ThunderFly-aerospace/TFPROBE01/doc_report/docs/TFPROBE01A-report.txt

# PCB

Board size: 14.0x10.0 mm (0.55x0.39 inches)

- This is the size of the rectangle that contains the board
- Thickness: 1.6 mm (63 mils)
- Material: FR4
- Finish: None
- Layers: 2
- Copper thickness: 35 µm

Solder mask: TOP / BOTTOM

- Color: Green

Silk screen: TOP / BOTTOM

- Color: White

Stackup:

| Name | Type | Color | Thickness | Material | Epsilon_r | Loss tangent |
|---|---|---|---|---|---|---|
| F.SilkS | Top Silk Screen | | | | | |
| F.Paste | Top Solder Paste | | | | | |
| F.Mask | Top Solder Mask | Green | 10 | | | |
| F.Cu | copper | | 35 | | | |
| dielectric 1 | core | | 1510 | FR4 | 4.5 | 0.02 |
| B.Cu | copper | | 35 | | | |
| B.Mask | Bottom Solder Mask | Green | 10 | | | |
| B.Paste | Bottom Solder Paste  | | | | | |
| B.SilkS | Bottom Silk Screen | | | | | |

# Important sizes

Clearance: 0.2 mm (8 mils)

Track width: 0.2 mm (8 mils)

- By design rules: 0.2 mm (8 mils)

Drill: 0.4 mm (16 mils)

- Vias: 0.4 mm (16 mils) [Design: 0.3 mm (12 mils)]
- Pads: 0.89 mm (35 mils)

Via: 0.8/0.4 mm (31/16 mils)

- By design rules: 0.4/0.3 mm (16/12 mils)
- Micro via: no [0.2/0.1 mm (8/4 mils)]
- Burried/blind via: no

Outer Annular Ring: 0.4 mm (16 mils)

- By design rules: 0.4 mm (16 mils)

Eurocircuits class: 4C

# General stats

Components count: (SMD/THT)

- Top: 0/3 (THT)
- Bottom: 4/1 (SMD + THT)

Defined tracks:

- 0.2 mm (8 mils)
- 0.3 mm (12 mils)
- 0.4 mm (16 mils)
- 0.5 mm (20 mils)

Used tracks:

- 0.2 mm (8 mils) (5) defined: yes
- 0.3 mm (12 mils) (3) defined: yes
- 0.5 mm (20 mils) (30) defined: yes

Defined vias:

- 0.8/0.4 mm (31/16 mils)

Used vias:

- 0.8/0.4 mm (31/16 mils) (Count: 10, Aspect: 2.0 A) defined: yes

Holes (excluding vias):

- 0.89 mm (35 mils) (3)
- 3.0 mm (118 mils) (2)
