ThunderFly-aerospace/TFPROBE01/doc/gen/img/pcb/TFPROBE01A-bottom.png

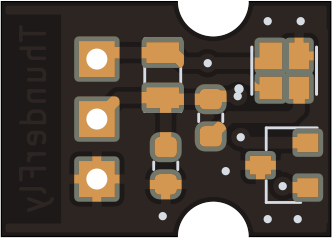
doc/gen/img/pcb/TFPROBE01A-bottom.png
