ThunderFly-aerospace/TFPROBE01/doc/gen/img/pcb/TFPROBE01A-top.png

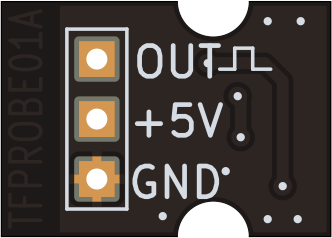
doc/gen/img/pcb/TFPROBE01A-top.png
