ThunderFly-aerospace/TFPROBE01/doc/gen/TFPROBE01A.step

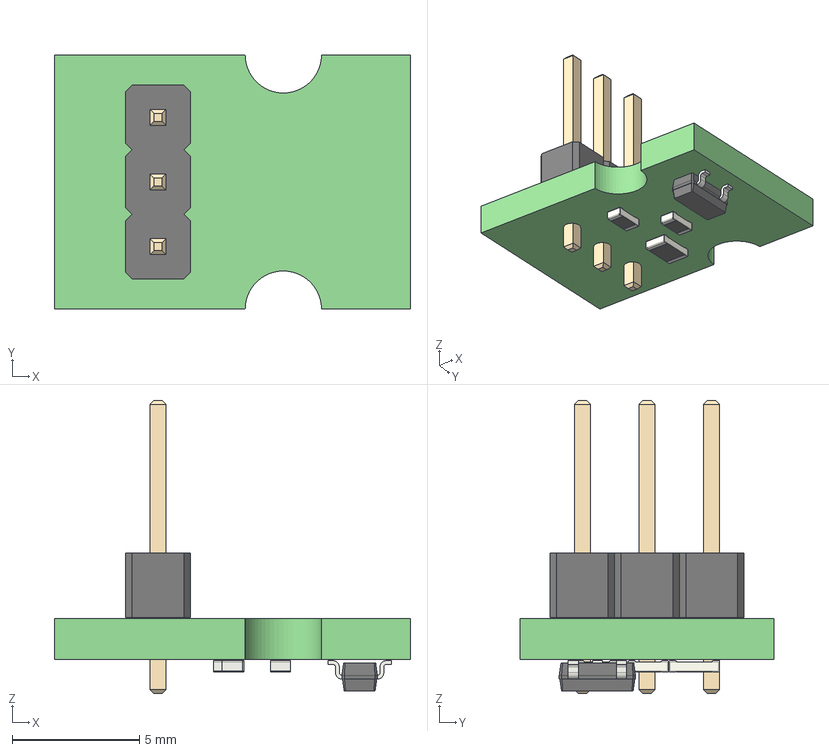
[picture p10: CAD file, 2023-08-10]
doc/gen/TFPROBE01A.step
14.0 x 10.0 x 11.5 mm
tmpk5qcnq6f PCB
