ThunderFly-aerospace/TFPROBE01/doc/gen/dxf/TFPROBE01A-F_Cu.dxf

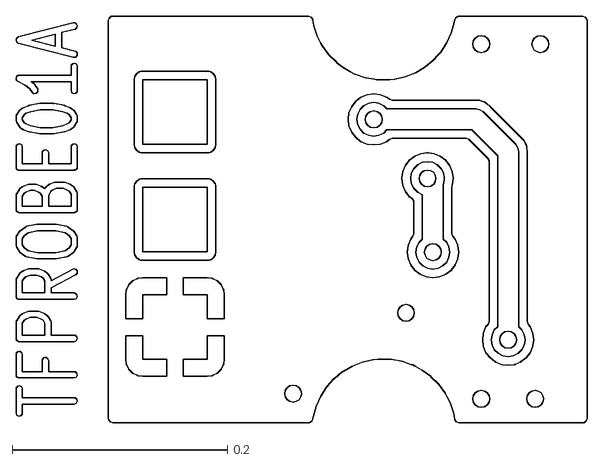
[picture p11: CAD file, 2022-10-18]
doc/gen/dxf/TFPROBE01A-F_Cu.dxf
0.531 x 0.378
