ThunderFly-aerospace/TFPROBE01/doc/gen/dxf/TFPROBE01A-B_Courtyard.dxf

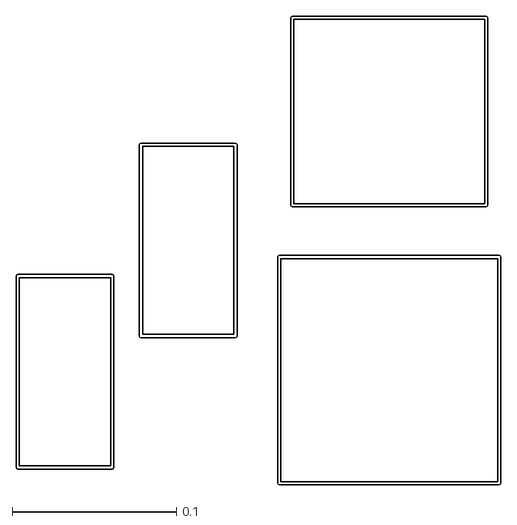
[picture p12: CAD file, 2022-10-18]
doc/gen/dxf/TFPROBE01A-B_Courtyard.dxf
0.295 x 0.285
