ThunderFly-aerospace/TFPROBE01/doc/gen/dxf/TFPROBE01A-F_Fab.dxf

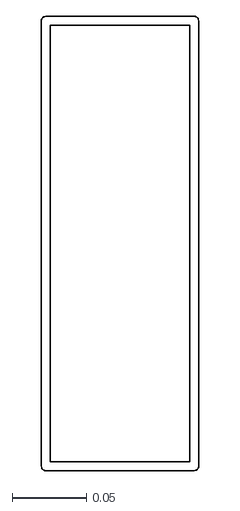
[picture p13: CAD file, 2022-10-18]
doc/gen/dxf/TFPROBE01A-F_Fab.dxf
0.106 x 0.306
