ThunderFly-aerospace/TFPROBE01/doc/gen/dxf/TFPROBE01A-B_Fab.dxf

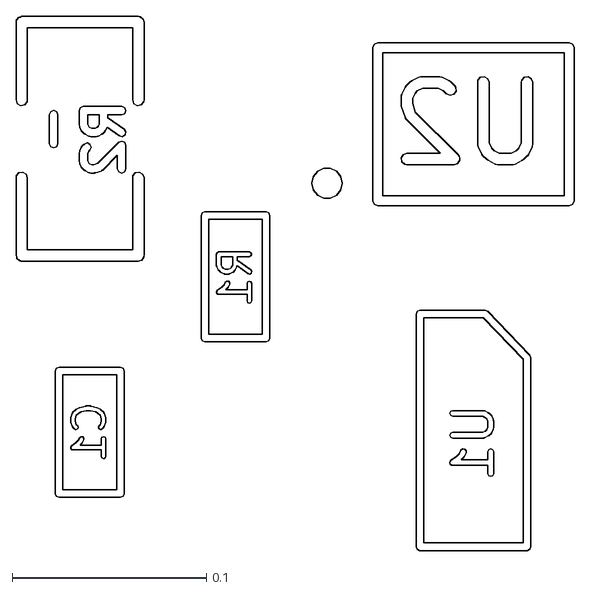
[picture p14: CAD file, 2022-10-18]
doc/gen/dxf/TFPROBE01A-B_Fab.dxf
0.287 x 0.275
