ThunderFly-aerospace/TFPROBE01/doc/gen/dxf/TFPROBE01A-B_Cu.dxf

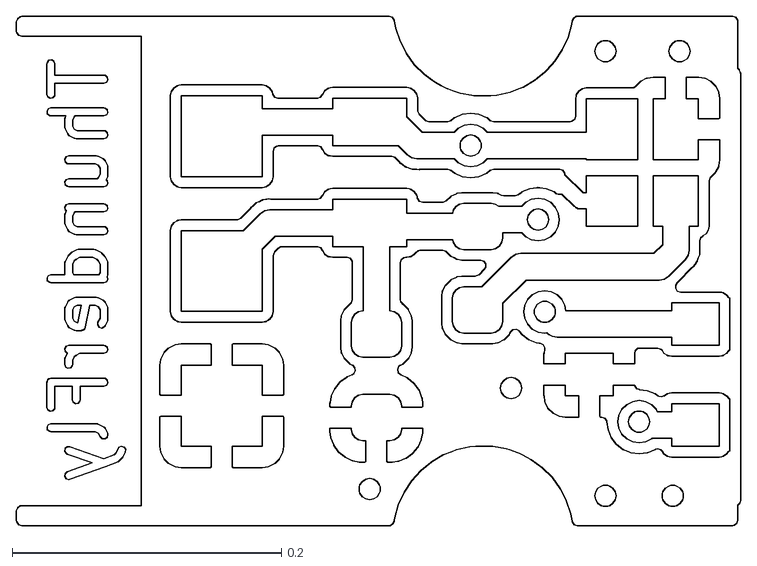
[picture p15: CAD file, 2022-10-18]
doc/gen/dxf/TFPROBE01A-B_Cu.dxf
0.537 x 0.378
