ThunderFly-aerospace/TFPROBE01/doc/gen/dxf/TFPROBE01A-Edge_Cuts.dxf

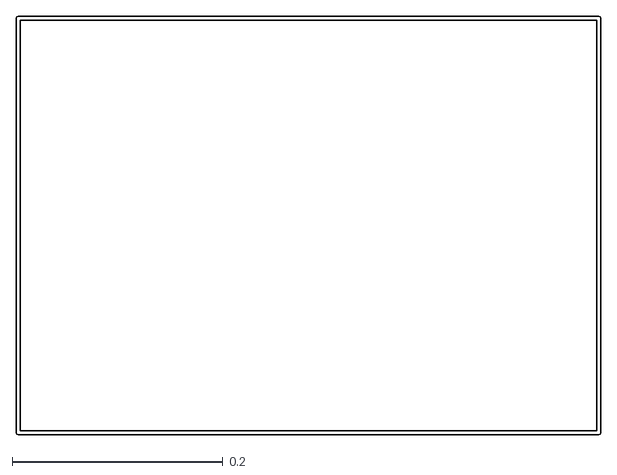
[picture p16: CAD file, 2022-10-18]
doc/gen/dxf/TFPROBE01A-Edge_Cuts.dxf
0.555 x 0.398
