ThunderFly-aerospace/TFPROBE01/(list of files, cad)

Other CAD files:
doc/gen/dxf/TFPROBE01A-User_5.dxf
doc/gen/dxf/TFPROBE01A-User_Comments.dxf
doc/gen/dxf/TFPROBE01A-User_Drawings.dxf
doc/gen/dxf/TFPROBE01A-User_8.dxf
doc/gen/dxf/TFPROBE01A-Margin.dxf
doc/gen/dxf/TFPROBE01A-B_Adhesive.dxf
doc/gen/dxf/TFPROBE01A-User_Eco2.dxf
doc/gen/dxf/TFPROBE01A-User_Eco1.dxf
doc/gen/dxf/TFPROBE01A-User_7.dxf
doc/gen/dxf/TFPROBE01A-F_Adhesive.dxf
doc/gen/dxf/TFPROBE01A-User_1.dxf
doc/gen/dxf/TFPROBE01A-User_9.dxf
doc/gen/dxf/TFPROBE01A-User_2.dxf
doc/gen/dxf/TFPROBE01A-User_4.dxf
doc/gen/dxf/TFPROBE01A-User_3.dxf
doc/gen/dxf/TFPROBE01A-F_Courtyard.dxf
doc/gen/dxf/TFPROBE01A-User_6.dxf
doc/gen/dxf/TFPROBE01A-B_Mask.dxf
doc/gen/dxf/TFPROBE01A-B_Paste.dxf
doc/gen/dxf/TFPROBE01A-B_Silkscreen.dxf
doc/gen/dxf/TFPROBE01A-F_Mask.dxf
doc/gen/dxf/TFPROBE01A-F_Paste.dxf
doc/gen/dxf/TFPROBE01A-F_Silkscreen.dxf
