ThunderFly-aerospace/TFPROBE01/doc/gen/TFPROBE01A-schematic.pdf

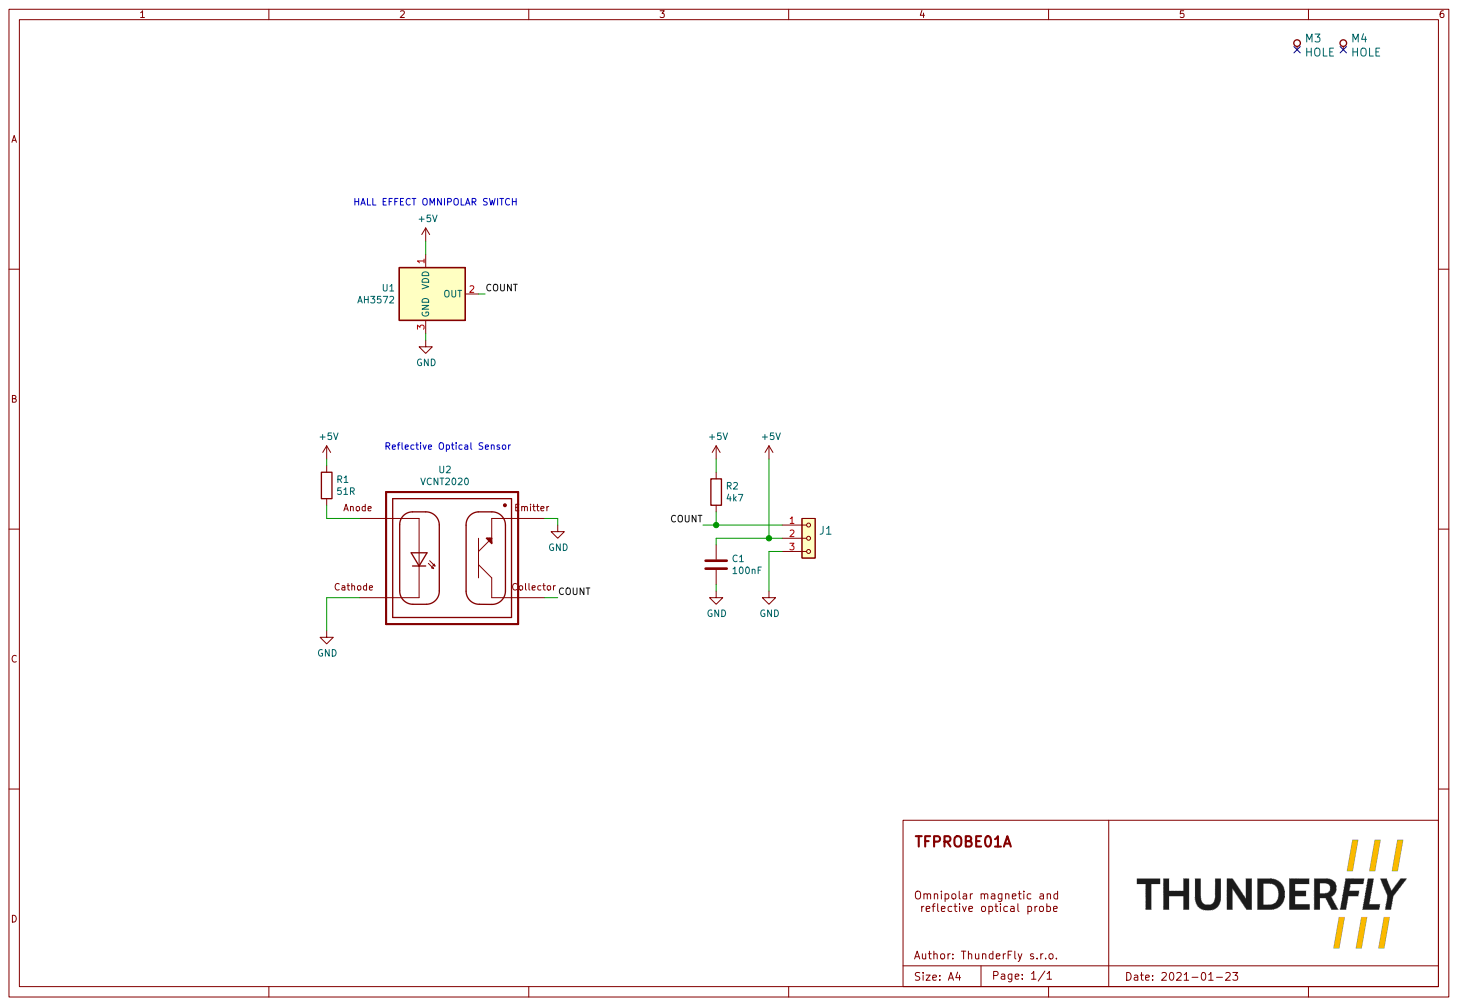
[picture p17: page 1]

+5V COUNT COUNT COUNT Reflective Optical Sensor HALL EFFECT OMNIPOLAR SWITCH
