ThunderFly-aerospace/TFPROBE01/hw/sch_pcb/TFPROBE01A.pdf

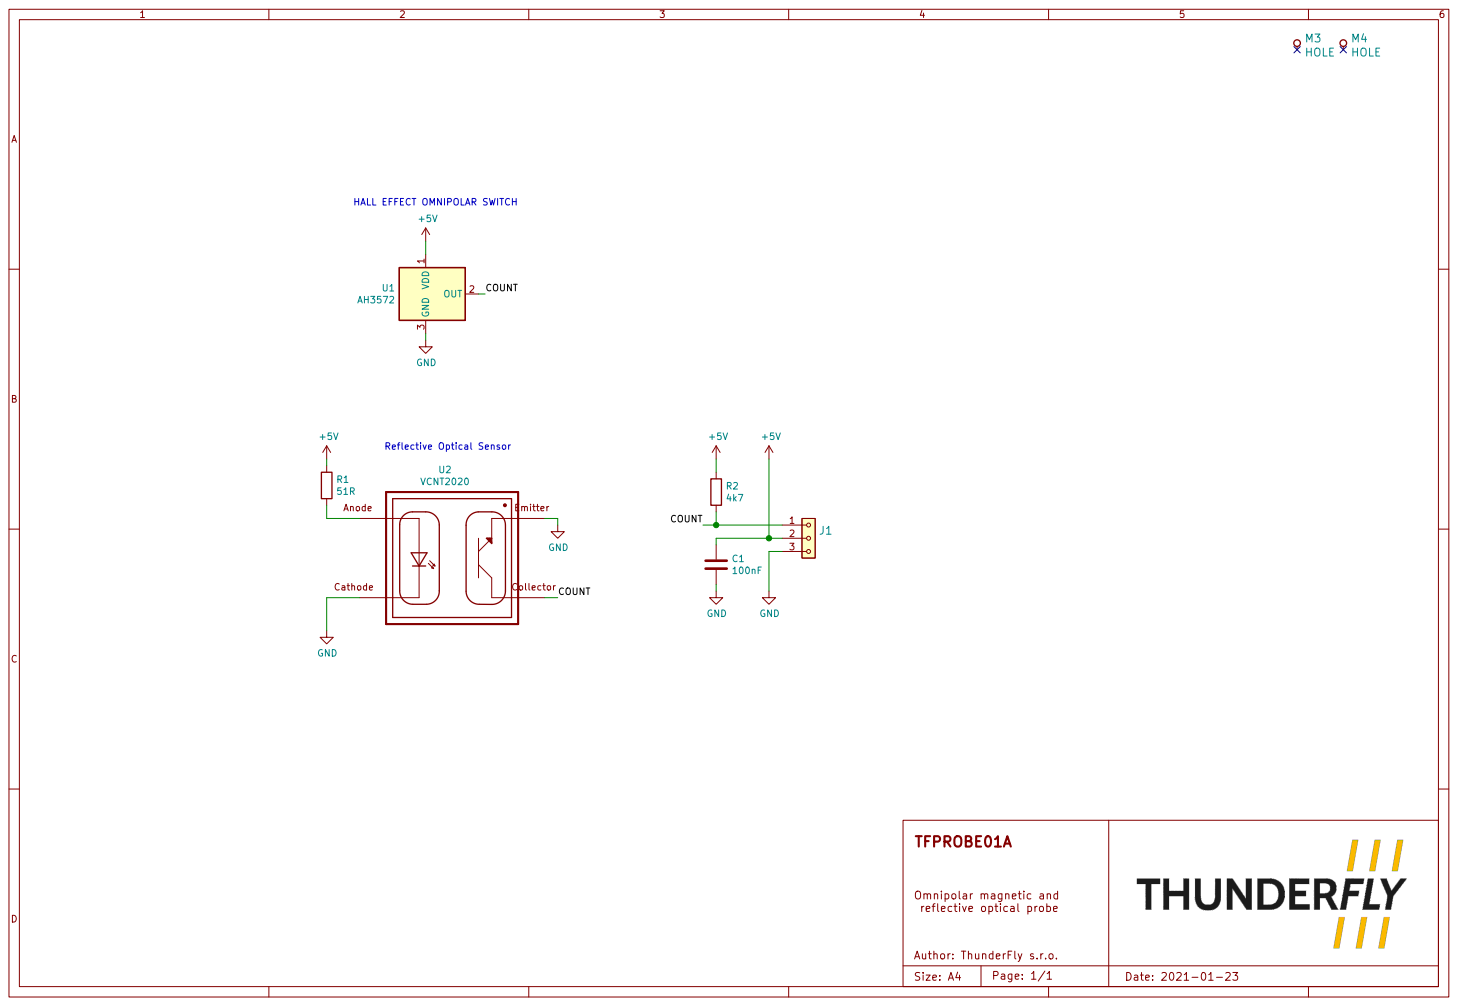
[picture p18: page 1]
