ThunderFly-aerospace/TFPROBE01/hw/sch_pcb/TFPROBE01A.kicad_pcb

## KiCad design hw/sch_pcb/TFPROBE01A.kicad_pcb (2023-08-12)

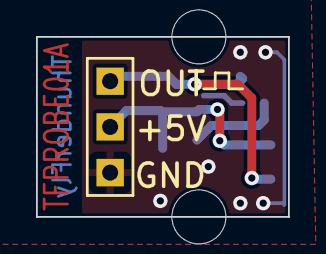
[picture p19: board TFPROBE01A.kicad_pcb from above]

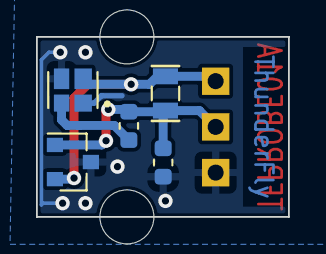
[picture p20: board TFPROBE01A.kicad_pcb from below]

Board: 2 copper layers, 14.0 x 10.0 mm, 8 parts (5 on the bottom side), 4 nets.

Parts:
C1: 100nF; SMD-0603
J1: HEADER_1x03; Straight_1x03
M3, M4: HOLE; dira_3mm
R1: 180R; SMD-0603
R2: -; SMD-0805
U1: AH3572; SOT-23
U2: VCNT2020; XDCR_VCNT2020

Connections:
+5V: C1.1, J1.2, R1.1, R2.1, U1.1 (VDD)
/COUNT: J1.1, R2.2, U1.2 (OUT), U2.2
GND: C1.2, J1.3, U1.3 (GND), U2.1, U2.4
unnamed: R1.2, U2.3
