ThunderFly-aerospace/TFPROBE01/(threads)

Thread 3 (2020-11-20):

Hřebínek je naletován ze stejné strany, jako snímače

kaklik, 2020-11-20:
Vertikální hřebínek je naletován tak, že jeho vývody jsou na stejnou stranu jako jsou snímače.  Vývody tak překáží v použití snímačů.

kaklik, 2020-11-20:
Konektor jsem otočil na opačnou stranu, ale teď jsou v repozitáři špatně obrázky..

ChroustJan, 2021-02-23:
@kaklik  jaké by tohle mělo mít řešení? Aby to šlo uzavřít.

roman-dvorak, 2021-02-23:
Myslím, že celý problém aktuálně spočívá v renderech, které to mají vyfocené obráceně.  Ale vzhledem k tomu, že máme fotky, tak ty rendery klidně vyhodit. Ale v kicadu by to chtělo opravit.

ChroustJan, 2021-02-23:
A to se to takto používat nebude? Protože takto máme i potisk na PCB. Odesíláme tyto sondy bez zapájení. Protože si dovedu představit, že to někdo muže použít i opačně.

roman-dvorak, 2021-02-23:
aha, nezapájený hřebínek to řeši dost dobře :) Tak já tam o tom připíšu poznámku.

ChroustJan, 2021-02-23:
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

roman-dvorak, 2021-02-23:
ok, takto bych to považoval za vyřešené.

kaklik, 2021-02-23:
No jde o to, že je to zatím asi blbě v datech na PCB. Důsledkem jsou pak ty otočené rendery a špatný osazováky.  Začalo to tím že od @ChroustJan  přišly PCB s hřebínkem naletovaným blbě, takže pokud je už něčím zajištěno, že se to nebude opakovat, tak je to možné uzavřít.

Closed 2021-02-23.

Thread 4 (2021-02-17):

Draw better diagram for magnet orientation

kaklik, 2021-02-17:
Currently, the only applicable statement is "the magnetic flux has to be perpendicular to PCB surface".

A better-describing image than one from the datasheet could improve the situation:

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

Thread 5 (2021-02-22):

Napájení IR LED TFPROBE

kaklik, 2021-02-22:
Zkoušel jsem změřit proud skrz IR LED, která je na TFPROBE. Provedl jsem to tak, že jsem změřil úbytek napětí na 100 Ohm rezistoru v RC článku TFRPM.
Naměřený úbytek na rezistoru je 1.41V. Což odpovídá proudu 1,41÷100 = 14,1 mA. Úbytek na IR diodě je 1,197V

Tento stav byl změřen při napájení autopilota z USB. Což je situace kdy na vstupu TFRPM je 4,57V.
V případě, že se měření zopakuje s externím napájením, kdy autopilot a tedy i TFRPM je napájen z power modulu a je tak na něm 5,21V, tak na rezistoru je úbytek 1.64 V, což odpovídá 16,4 mA. Na IR diodě je v takové situaci úbytek 1,2V.

Podle [datasheetu k reflexnímu snímači](https://github.com/ThunderFly-aerospace/TFPROBE01/blob/TFPROBE01A/doc/datasheets/vcnt2020.pdf) může IR LED trvale protékat až 100mA.  Je zde tak značná rezerva pro snížení rezistoru R1 před IR LED.

Vhodným nastavením rezistoru R1 na TFPROBE by zřejmě byla situace, kdy úbytek napětí na rezistoru R2 v TFRPM01C bude takový, aby napájení TFPROBE a tím pádem i hodnota napětí pull-upu R1 (na TFPRM) bylo stejné, jako je [napájecí napětí schmitova klopného obvodu U2A](https://github.com/ThunderFly-aerospace/TFRPM01/issues/16), nebo mírně menší.

Tím dojde k nejlepšímu využití napěťových úrovní vstupu klopného obvodu a tím pádem k nejmenší citlivosti na odrazný materiál, nebo parametry vstupního napájení, či různorodost sérií klopných obvodů.

kaklik, 2021-02-22:
Tak vhodný rezistor R1 do TFPROBE by mohl být zřejmě něco jako 87,5 Ohm.  Nejbližší v běžné řadě je však 82 nebo 100 Ohm.

kaklik, 2021-02-23:
V noci jsem zjistil, že původní úvaha obsahuje chybu, neboť snížení rezistoru R1 na TFPROBE nesnižuje napájecí napětí pro pull-up na TFRPM. Tato záležitost komplikuje situaci a zřejmě tak bude nutné aplikovat i pull-up na TFPROBE, kde ke snížení napájecího napětí pull-upu v důsledku zatížení napájení dochází.
Neboť je potřeba aby logické úrovně výstupu TFPROBE byly co nejlépe přizpůsobeny rozhodovacím úrovním TFRPM.

kaklik, 2021-02-23:
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

kaklik, 2021-03-04:
Rezistor R1 nastavující proud do IR LED by zřejmě bylo vhodné snížit až na 62 Ohm.
Rezistor R2 by naopak nově měl být osazen pull-upem 4k7.

kaklik, 2021-03-21:
Na pozici R1 @ChroustJan  nakonec osadil 51 Ohm.  Úbytek naměřený na rezistoru R1 je 1,19V, což odpovídá proudu skrz IR LED 23,3 mA.

Test snímání je proveden v issue: https://github.com/ThunderFly-aerospace/TFRPM01/issues/10

Closed 2021-03-21.

Thread 7 (2021-06-01):

Bad version of schematics in README

roman-dvorak, 2021-06-01:
README obsahuje nějaké staré PDF se schématem. Je potřeba zkontrolovat správnosti cest a jestli repozitář neobsahuje nějaké duplicity.

kaklik, 2021-06-01:
Myslím si, že primární příčina tohoto stavu je [nefunční KiCAD workflow](https://github.com/ThunderFly-aerospace/TFPROBE01/actions).

Thread 8 (2024-10-23):

Combustion engine sensing probe

kaklik, 2024-10-23:
It would be beneficial to create a new product, TFPROBE02, designed specifically for capacitive or voltage-based RPM sensing in internal combustion engines. This product could address the need for signal conditioning when connecting ignition modules,

By offering this dedicated probe, we could simplify the setup process for customers and provide a ready-made solution for accurate RPM measurement without needing external signal conditioning components such as resistor dividers, optical, or capacitive coupling.

kaklik, 2024-10-24:
Ještě mne k tomuto napadl takový dodatek - Bylo by zřejmě vhodné, kdyby sonda měla víc jak jeden vstup pro zapalování, důvod je ten že letecké motory bývají často víceválcové, takže by se tím zvětšilo rozlišení RPM.

Technicky by to šlo vyřešit tak, že se jednotlivé vstupy vzájemně sečtou. Protože zapalování bude pravděpodobně fázově rozložené do průběhu celé otáčky.
