ThunderFly-aerospace/TFPROBE01/(commit log)

2020-10-31 Edit bom
    [OPTMAGPROBE01A.kicad_sch]
2020-11-01 Přejmenování modulu. Generování výrobních dat.
    [OPTMAGPROBE01A-B_Cu.gbr, OPTMAGPROBE01A-B_Mask.gbr, OPTMAGPROBE01A-B_Paste.gbr, OPTMAGPROBE01A-B_Silkscreen.gbr, OPTMAGPROBE01A-Edge_Cuts.gbr, OPTMAGPROBE01A-F_Cu.gbr, OPTMAGPROBE01A-F_Mask.gbr, OPTMAGPROBE01A-F_Paste.gbr]
2020-11-01 Odstranění starých dat.
    [OPTMAGPROBE01A-B_Cu.gbr, OPTMAGPROBE01A-B_Mask.gbr, OPTMAGPROBE01A-B_Paste.gbr, OPTMAGPROBE01A-B_Silkscreen.gbr, OPTMAGPROBE01A-Edge_Cuts.gbr, OPTMAGPROBE01A-F_Cu.gbr, OPTMAGPROBE01A-F_Mask.gbr, OPTMAGPROBE01A-F_Paste.gbr]
2020-11-01 Přidány kóty.
    [TFPROBE01A.kicad_pcb]
2020-11-04 Edit cam
    [TFPROBE01A-B_Cu.gbr, TFPROBE01A-B_Mask.gbr, TFPROBE01A-Edge_Cuts.gbr, TFPROBE01A-F_Cu.gbr, TFPROBE01A-F_Mask.gbr, TFPROBE01A-F_Silkscreen.gbr, TFPROBE01A-NPTH.drl, TFPROBE01A-PTH.drl]
2020-11-12 Edit schema
    [TFPROBE01A.kicad_sch]
2020-11-20 Flip pin-header connector to opposite side. #3
    [TFPROBE01A.kicad_pcb]
2020-11-25 Schematic export.
2021-01-23 Update title block.
    [TFPROBE01A.kicad_sch]
2021-02-22 Improve documentation, images and automation.
    [TFPROBE01A.kicad_sch]
2021-04-03 Changing component values #5
    [TFPROBE01A.kicad_sch]
2021-04-05 Improve the schematics title blocks.
2021-04-07 Update documentation regarding the dimensions of the PCB.
    [TFPROBE01A-B_Cu.gbr, TFPROBE01A-B_Mask.gbr, TFPROBE01A-Edge_Cuts.gbr, TFPROBE01A-F_Cu.gbr, TFPROBE01A-F_Mask.gbr, TFPROBE01A-F_Silkscreen.gbr, TFPROBE01A-User_Comments.gbr, TFPROBE01A-job.gbrjob]
2021-08-09 Add dimensions to optical probe sensor.
    [TFPROBE01A.kicad_pcb]
2022-10-18 Edit PCB
    [TFPROBE01A.kicad_pcb]
2022-10-18 Update actions products
    [TFPROBE01A-B_Cu.gbr, TFPROBE01A-B_Mask.gbr, TFPROBE01A-Edge_Cuts.gbr, TFPROBE01A-F_Cu.gbr, TFPROBE01A-F_Mask.gbr, TFPROBE01A-F_Silkscreen.gbr, TFPROBE01A-NPTH.drl, TFPROBE01A-PTH.drl]
2023-08-10 Update README.md
    check the spelling
    add a link to the optical sensor datasheet.
2023-08-12 Update sensors position dimensions
    [TFPROBE01A.kicad_pcb, TFPROBE01A.kicad_sch]
